fossasia/magic-epaper-hardware/(threads)

Thread 3 (2025-02-28):

The display hangs (BUSY_N tie to low) after sending power on command

kienvo, 2025-02-28:
This wasted me a whole week, and then I tried replacing the MOSFET with 2N7000, and eventually figured it out.

The reason was the driver (UC8252) checks for the output of the booster, and the regulators. When all voltages are ready, the BUSY_N signal will return to high. But the Si2308 mosfet has the maximum V<sub>GS(th)</sub> = 3v since the recommended value should be V<sub>GS(th)</sub> < 1.5v (in the UC8252 datasheet) so it does not generate enough voltage to the VGH and VGL pins. So checks fail, and the BUSY_N pin stays low.

The UC8252 recommends Si1308 or Si1304. I can't find any of those at my local shops. But the Good Display site recommends AO3400. I'll try it and make a fix soon.

mariobehling, 2025-03-02:
Good.

Closed 2025-04-08.

Thread 4 (2025-02-28):

The USB-C receptacle can't reach the edge of the display

kienvo, 2025-02-28:
There is a space between the USB-C and the edge of the display. It is difficult to plug in the USB.

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

Also, the FPC cable of the display is not center-aligned, but the FPC connector is, causing the whole board to be not center-aligned with the display.

Closed 2025-04-08.

Thread 9 (2025-06-17):

Insufficient power with NFC Energy Harvesting

kienvo, 2025-06-17:
The energy stored in the tank circuit is about 4.2v will drops to 1.6v once a full refreshing happens. This can be fixed in one of two ways:

- Increasing the value of the current sensing resistor, which has been made as an option by JP2 to switch between R9 and R4. The drawback is that the display pixel will be blurred.
- Partial refreshing instead of a full refreshing.
