fossasia/magic-epaper-hardware/(commit log)

2025-02-08 Initial design (#1)
    * add initial schematic
    * add epd circuit
    * usb, nfc ant, debug port
    * lay out PCB
    * add custom FPC connector and placed components
    * finish layout and artwork
    * add board preview
    * finish bom, readme
    [bill-of-materials.csv, magic-epaper.kicad_pcb, magic-epaper.kicad_sch]
2025-03-04 fix: boost circuit, board's size, and i2c lines
    Changes:
    - Changed the mosfet to AO3400 (resolves #3)
    - Increased board's size to fit the the display (resolves #4)
    - Switched the I2C lines together (resolves #2)
    [magic-epaper.kicad_pcb, magic-epaper.kicad_sch]
2025-03-19 move component to one side to reduce board thickness
    [bill-of-materials.csv, magic-epaper.kicad_pcb, magic-epaper.kicad_sch]
2025-03-20 re-align the fpc to fit the current display
    [magic-epaper.kicad_pcb]
2025-03-27 add a jumper to change between high/low power boost
    default to low power boost
    [magic-epaper.kicad_pcb, magic-epaper.kicad_sch]
2025-06-24 add gerber file (#12)
    [magic-epaper-B_Cu.gbr, magic-epaper-B_Mask.gbr, magic-epaper-B_Paste.gbr, magic-epaper-B_Silkscreen.gbr, magic-epaper-Edge_Cuts.gbr, magic-epaper-F_Cu.gbr, magic-epaper-F_Mask.gbr, magic-epaper-F_Paste.gbr]
2025-07-15 move DPU line and its pull-up resistor to DN (#14)
    [magic-epaper.kicad_pcb, magic-epaper.kicad_sch]
2025-09-25 fix: added capacitor values for tuning (#16)
    * fix: added capacitor values for tuning
    * docs: updated bom
    [bill-of-materials.csv, magic-epaper.kicad_sch]
